grazzland/E-GIF-M-Board/README.md

# E-GIF-M-Board
Extendable Gateway and Industrial Firewall-ModBus
