grazzland/E-GIF-M-Board/E-GIF-M-Board.kicad_pcb

## KiCad design E-GIF-M-Board.kicad_pcb (2017-03-09)

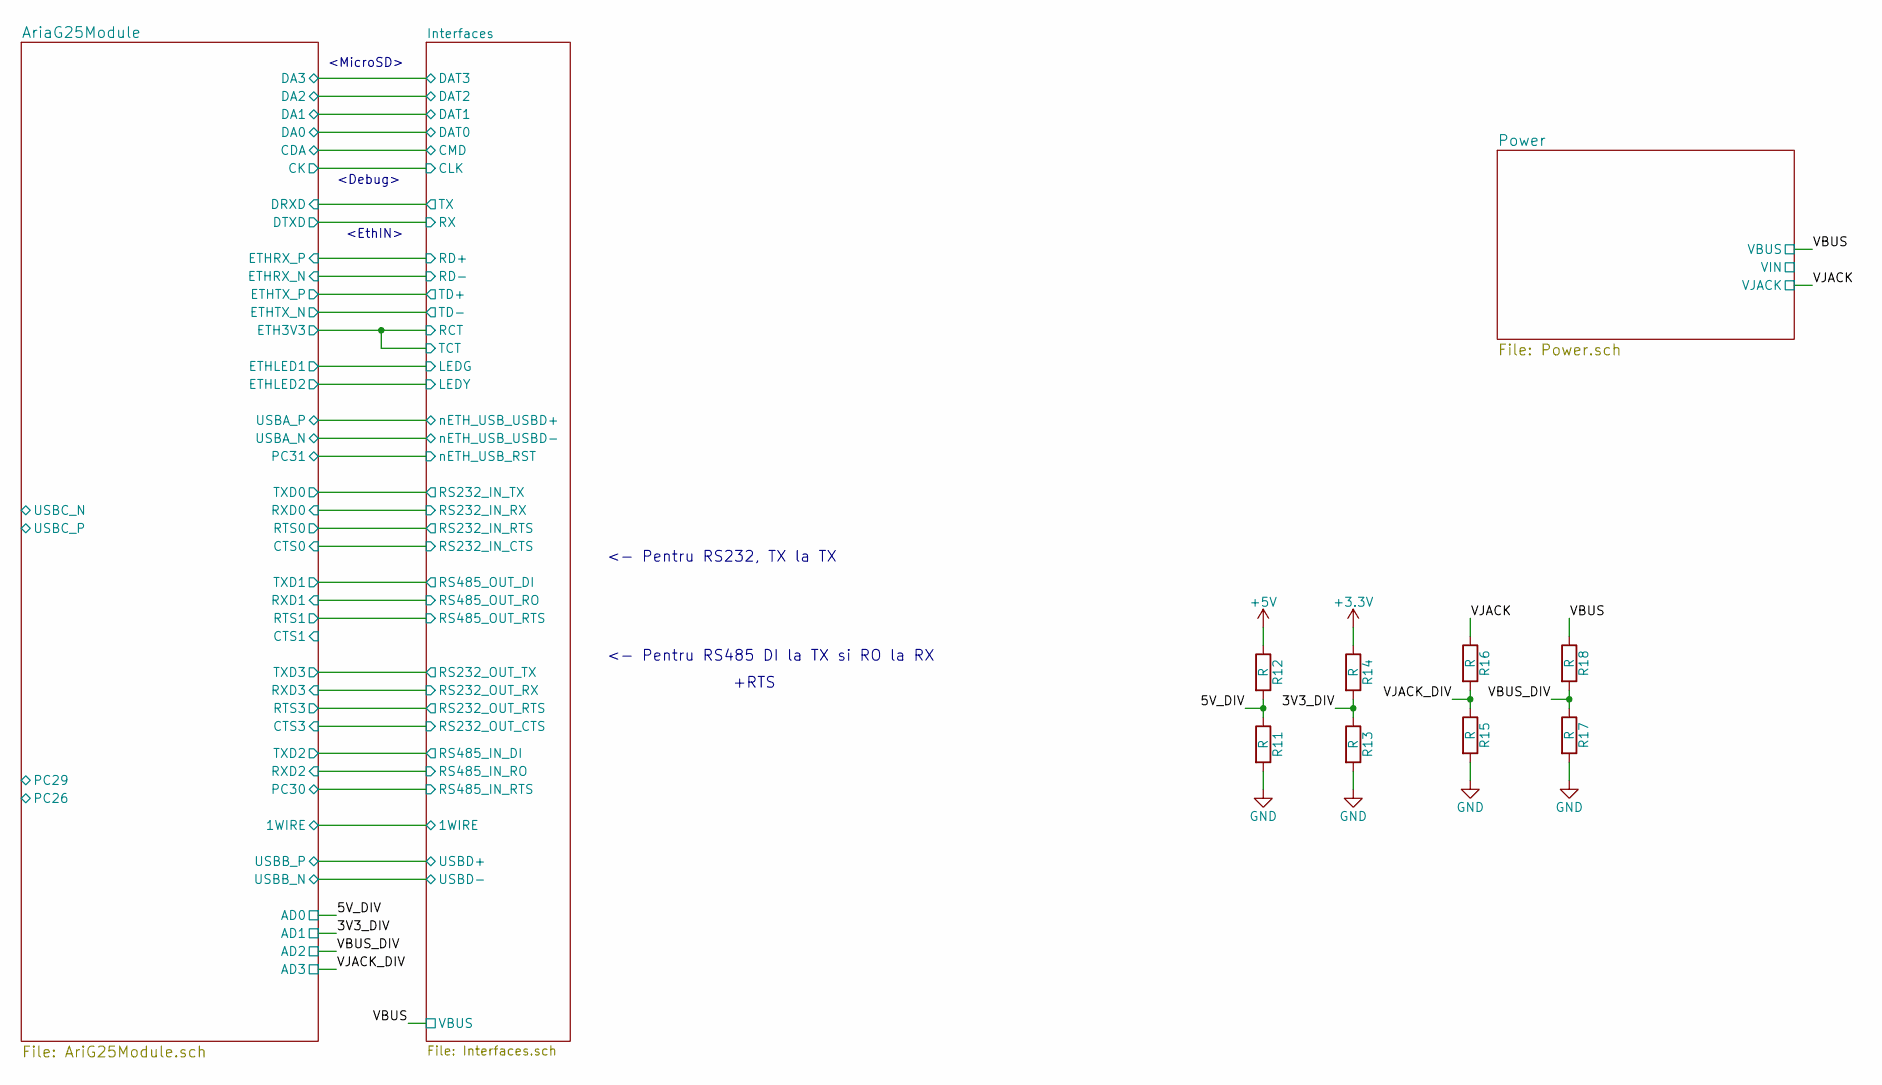
[picture p1: schematic E-GIF-M-Board.sch, E-GIF-M Board]

Parts:
R11, R12, R13, R14, R15, R16, R17, R18: R

Connections:
+3V3: R14.1; also elsewhere on the board
+5V: R12.1; also elsewhere on the board
/3V3_DIV: R13.1, R14.2; also elsewhere on the board
/5V_DIV: R11.1, R12.2; also elsewhere on the board
/VBUS: R18.1; also elsewhere on the board
/VBUS_DIV: R17.1, R18.2; also elsewhere on the board
/VJACK: R16.1; also elsewhere on the board
/VJACK_DIV: R15.1, R16.2; also elsewhere on the board
GND: R11.2, R13.2, R15.2, R17.2; also elsewhere on the board

Notes on the sheet:
<MicroSD>
<Debug>
<EthIN>
<- Pentru RS232, TX la TX
<- Pentru RS485 DI la TX si RO la RX
+RTS

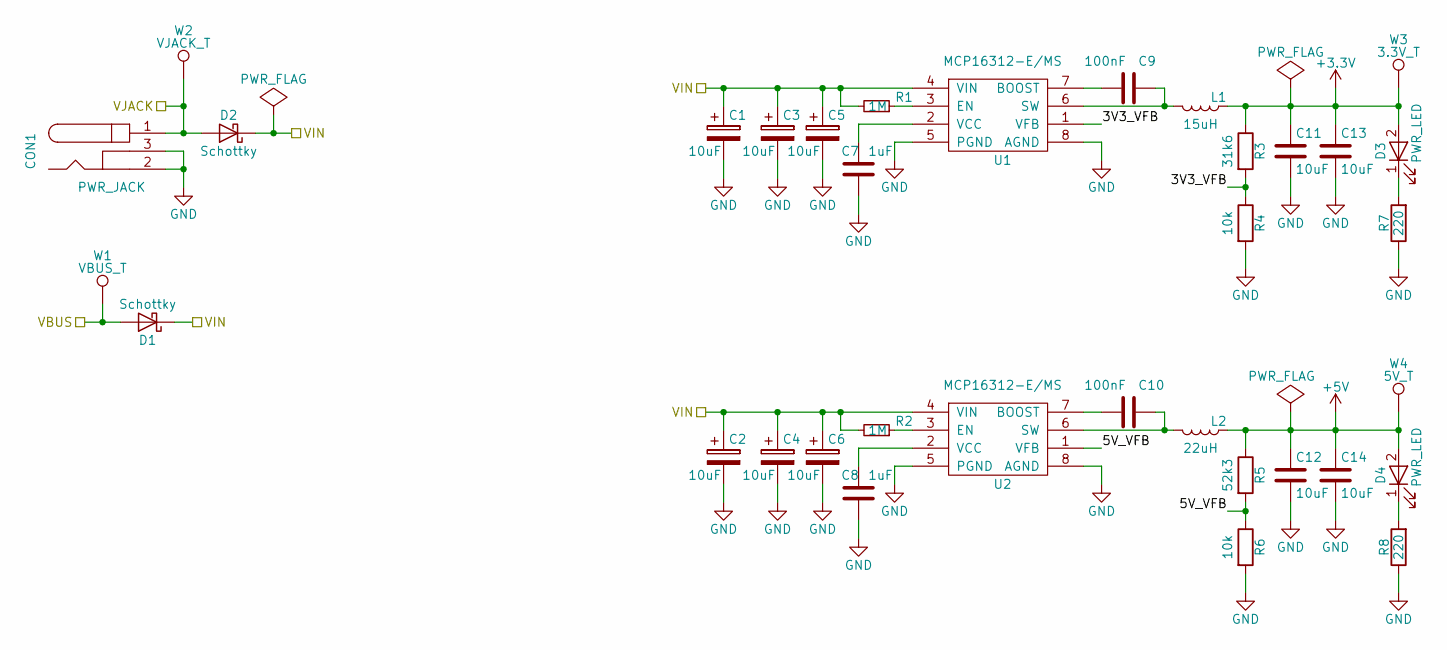
[picture p2: schematic Power.sch]

Parts:
C1, C2, C3, C4, C5, C6: 10uF; CP_Tantalum_Case-B_EIA-3528-21_Hand
C7, C8: 1uF; C_0603_HandSoldering
C9, C10: 100nF; C_0603_HandSoldering
C11, C12, C13, C14: 10uF; C_0603_HandSoldering
CON1: PWR_JACK; BARREL_JACK
D1, D2: Schottky; D_SMA-SMB_Universal_Handsoldering
D3, D4: PWR_LED; LED_0603
L1: 15uH; Inductor_Taiyo-Yuden_MD-5050
L2: 22uH; Inductor_Taiyo-Yuden_MD-5050
R1, R2: 1M; R_0603_HandSoldering
R3: 31k6; R_0603_HandSoldering
R4, R6: 10k; R_0603_HandSoldering
R5: 52k3; R_0603_HandSoldering
R7, R8: 220; R_0603_HandSoldering
U1, U2: MCP16312-E/MS; MSOP-8_3x3mm_Pitch0.65mm
W1: VBUS_T; Measurement_Point_Round-SMD-Pad_Small
W2: VJACK_T; Measurement_Point_Round-SMD-Pad_Small
W3: 3.3V_T; Measurement_Point_Round-SMD-Pad_Small
W4: 5V_T; Measurement_Point_Round-SMD-Pad_Small

Connections:
+3V3: C11.1, C13.1, D3.2 (A), L1.1, R3.1, W3.1; also elsewhere on the board
+5V: C12.1, C14.1, D4.2 (A), L2.1, R5.1, W4.1; also elsewhere on the board
/Power/3V3_VFB: R3.2, R4.1, U1.1 (VFB)
/Power/5V_VFB: R5.2, R6.1, U2.1 (VFB)
/Power/VIN: C1.1, C2.1, C3.1, C4.1, C5.1, C6.1, D1.1 (K), D2.1 (K), R1.2, R2.2, U1.4 (VIN), U2.4 (VIN)
/VBUS: D1.2 (A), W1.1; also elsewhere on the board
/VJACK: CON1.1, D2.2 (A), W2.1; also elsewhere on the board
GND: C1.2, C2.2, C3.2, C4.2, C5.2, C6.2, C7.2, C8.2, C11.2, C12.2, C13.2, C14.2, CON1.2, CON1.3, R4.2, R6.2, R7.1, R8.1, U1.5 (PGND), U1.8 (AGND), U2.5 (PGND), U2.8 (AGND); also elsewhere on the board
unnamed: C7.1, U1.2 (VCC)
unnamed: C8.1, U2.2 (VCC)
unnamed: C9.1, L1.2, U1.6 (SW)
unnamed: C9.2, U1.7 (BOOST)
unnamed: C10.1, L2.2, U2.6 (SW)
unnamed: C10.2, U2.7 (BOOST)
unnamed: D3.1 (K), R7.2
unnamed: D4.1 (K), R8.2
unnamed: R1.1, U1.3 (EN)
unnamed: R2.1, U2.3 (EN)

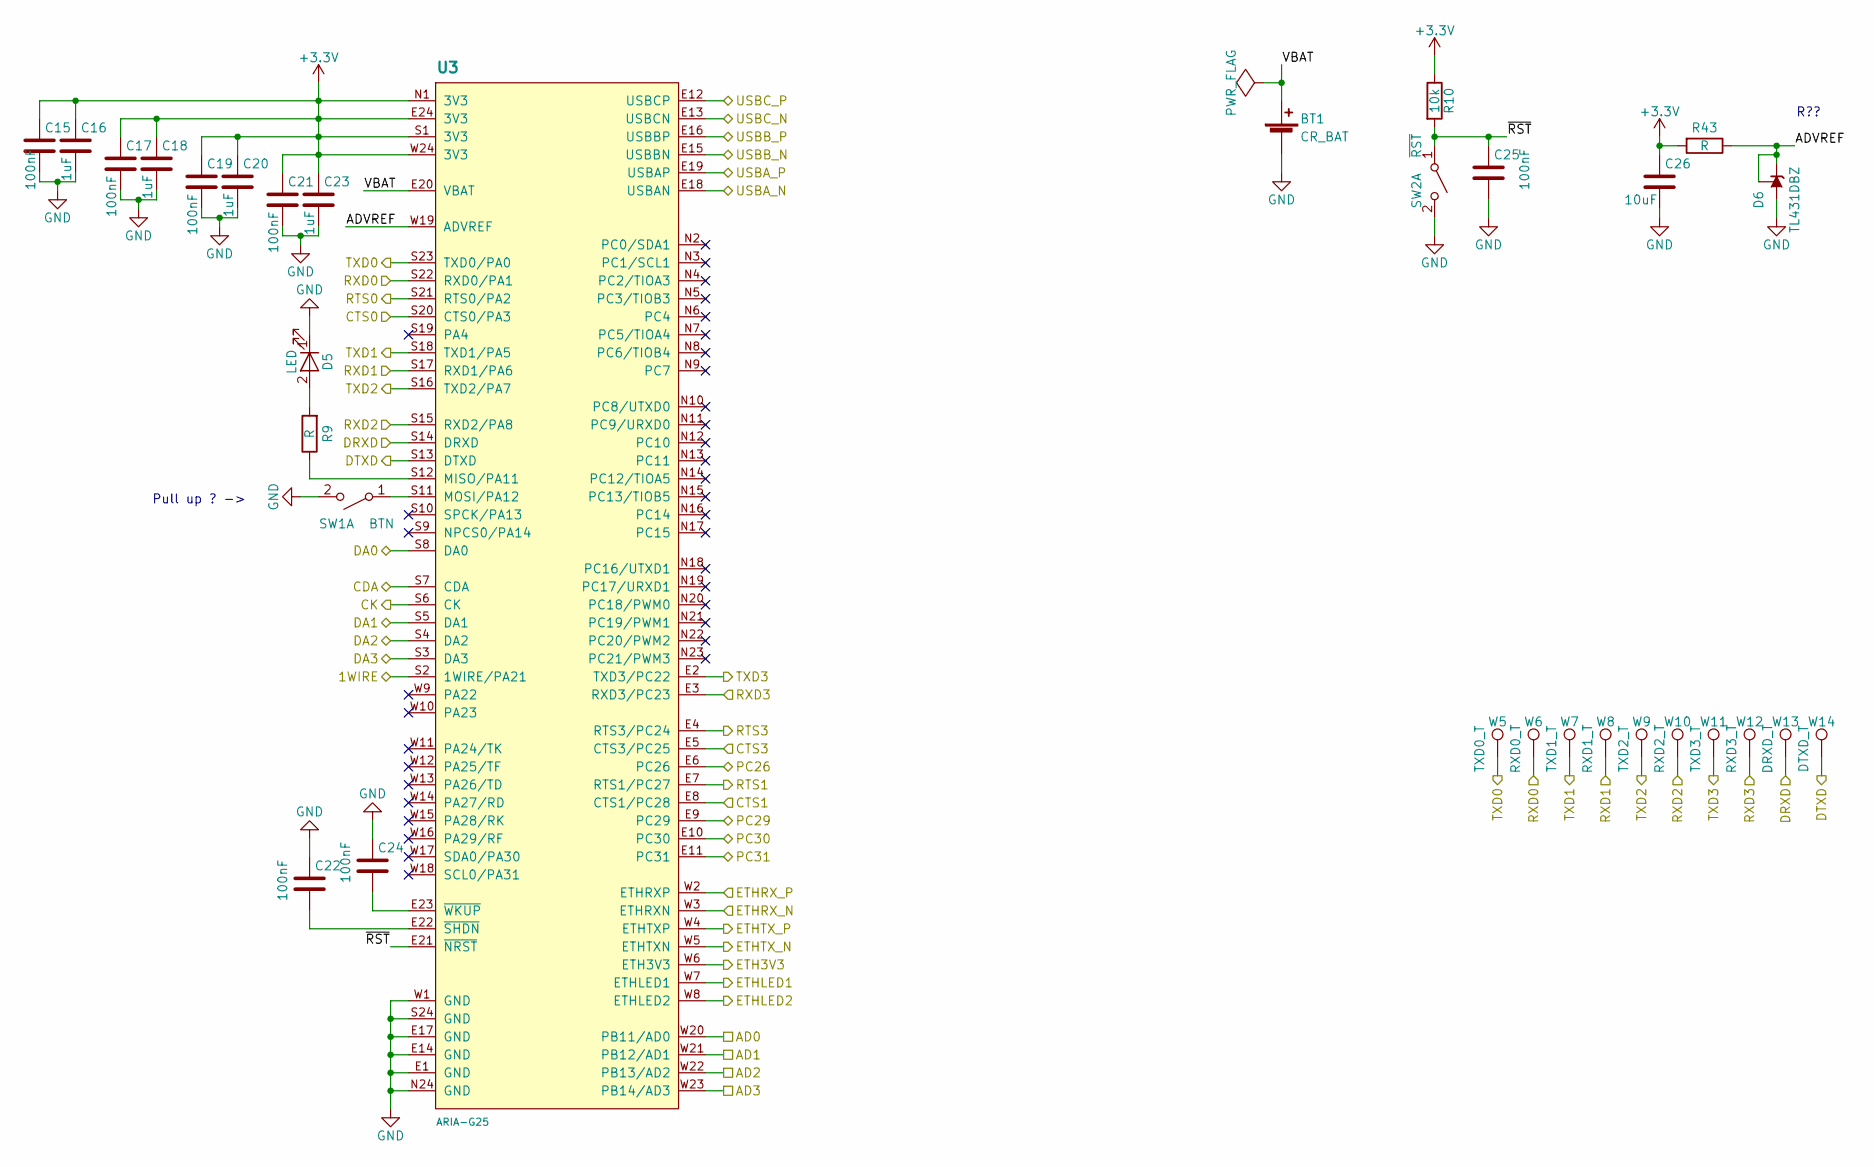
[picture p3: schematic AriG25Module.sch]

Parts:
BT1: CR_BAT; BatteryHolder_CoinCell_Keystone_3001
C15, C17, C19, C21, C22, C24, C25: 100nF; C_0603_HandSoldering
C16, C18, C20, C23: 1uF; C_0603_HandSoldering
C26: 10uF; C_0603_HandSoldering
D5: LED; LED_0603
D6: TL431DBZ; SOT-23
R9, R43: R; R_0603_HandSoldering
R10: 10k; R_0603_HandSoldering
SW1: BTN; SW_SPST_EVQPE1
SW2: ~RST; SW_SPST_EVQPE1
U3: ARIA-G25
W5: TXD0_T; Measurement_Point_Round-SMD-Pad_Small
W6: RXD0_T; Measurement_Point_Round-SMD-Pad_Small
W7: TXD1_T; Measurement_Point_Round-SMD-Pad_Small
W8: RXD1_T; Measurement_Point_Round-SMD-Pad_Small
W9: TXD2_T; Measurement_Point_Round-SMD-Pad_Small
W10: RXD2_T; Measurement_Point_Round-SMD-Pad_Small
W11: TXD3_T; Measurement_Point_Round-SMD-Pad_Small
W12: RXD3_T; Measurement_Point_Round-SMD-Pad_Small
W13: DRXD_T; Measurement_Point_Round-SMD-Pad_Small
W14: DTXD_T; Measurement_Point_Round-SMD-Pad_Small

Connections:
+3V3: C15.1, C16.1, C17.1, C18.1, C19.1, C20.1, C21.1, C23.1, C26.1, R10.1, R43.2, U3.E24 (3V3), U3.N1 (3V3), U3.S1 (3V3), U3.W24 (3V3); also elsewhere on the board
/3V3_DIV: U3.W21 (PB12/AD1); also elsewhere on the board
/5V_DIV: U3.W20 (PB11/AD0); also elsewhere on the board
/AriaG25Module/1WIRE: U3.S2 (1WIRE/PA21); also elsewhere on the board
/AriaG25Module/ADVREF: D6.1 (K), D6.2 (REF), R43.1, U3.W19 (ADVREF)
/AriaG25Module/CDA: U3.S7 (CDA); also elsewhere on the board
/AriaG25Module/CK: U3.S6 (CK); also elsewhere on the board
/AriaG25Module/CTS0: U3.S20 (CTS0/PA3); also elsewhere on the board
/AriaG25Module/CTS1: U3.E8 (CTS1/PC28)
/AriaG25Module/CTS3: U3.E5 (CTS3/PC25); also elsewhere on the board
/AriaG25Module/DA0: U3.S8 (DA0); also elsewhere on the board
/AriaG25Module/DA1: U3.S5 (DA1); also elsewhere on the board
/AriaG25Module/DA2: U3.S4 (DA2); also elsewhere on the board
/AriaG25Module/DA3: U3.S3 (DA3); also elsewhere on the board
/AriaG25Module/DRXD: U3.S14 (DRXD), W13.1; also elsewhere on the board
/AriaG25Module/DTXD: U3.S13 (DTXD), W14.1; also elsewhere on the board
/AriaG25Module/ETH3V3: U3.W6 (ETH3V3); also elsewhere on the board
/AriaG25Module/ETHLED1: U3.W7 (ETHLED1); also elsewhere on the board
/AriaG25Module/ETHLED2: U3.W8 (ETHLED2); also elsewhere on the board
/AriaG25Module/ETHRX_N: U3.W3 (ETHRXN); also elsewhere on the board
/AriaG25Module/ETHRX_P: U3.W2 (ETHRXP); also elsewhere on the board
/AriaG25Module/ETHTX_N: U3.W5 (ETHTXN); also elsewhere on the board
/AriaG25Module/ETHTX_P: U3.W4 (ETHTXP); also elsewhere on the board
/AriaG25Module/PC26: U3.E6 (PC26)
/AriaG25Module/PC29: U3.E9 (PC29)
/AriaG25Module/PC30: U3.E10 (PC30); also elsewhere on the board
/AriaG25Module/PC31: U3.E11 (PC31); also elsewhere on the board
/AriaG25Module/USBA_N: U3.E18 (USBAN); also elsewhere on the board
/AriaG25Module/USBA_P: U3.E19 (USBAP); also elsewhere on the board
/AriaG25Module/USBB_N: U3.E15 (USBBN); also elsewhere on the board
/AriaG25Module/USBB_P: U3.E16 (USBBP); also elsewhere on the board
/AriaG25Module/USBC_N: U3.E13 (USBCN)
/AriaG25Module/USBC_P: U3.E12 (USBCP)
/AriaG25Module/VBAT: BT1.1 (+), U3.E20 (VBAT)
/AriaG25Module/~RST: C25.1, R10.2, SW2.1 (A), U3.E21 (~NRST)
/Interfaces/RS232_IN_RTS: U3.S21 (RTS0/PA2); also elsewhere on the board
/Interfaces/RS232_IN_RX: U3.S22 (RXD0/PA1), W6.1; also elsewhere on the board
/Interfaces/RS232_IN_TX: U3.S23 (TXD0/PA0), W5.1; also elsewhere on the board
/Interfaces/RS232_OUT_RTS: U3.E4 (RTS3/PC24); also elsewhere on the board
/Interfaces/RS232_OUT_RX: U3.E3 (RXD3/PC23), W12.1; also elsewhere on the board
/Interfaces/RS232_OUT_TX: U3.E2 (TXD3/PC22), W11.1; also elsewhere on the board
/Interfaces/RS485_IN_DI: U3.S16 (TXD2/PA7), W9.1; also elsewhere on the board
/Interfaces/RS485_IN_RO: U3.S15 (RXD2/PA8), W10.1; also elsewhere on the board
/Interfaces/RS485_OUT_DI: U3.S18 (TXD1/PA5), W7.1; also elsewhere on the board
/Interfaces/RS485_OUT_RO: U3.S17 (RXD1/PA6), W8.1; also elsewhere on the board
/Interfaces/RS485_OUT_RTS: U3.E7 (RTS1/PC27); also elsewhere on the board
/VBUS_DIV: U3.W22 (PB13/AD2); also elsewhere on the board
/VJACK_DIV: U3.W23 (PB14/AD3); also elsewhere on the board
GND: BT1.2 (-), C15.2, C16.2, C17.2, C18.2, C19.2, C20.2, C21.2, C22.1, C23.2, C24.1, C25.2, C26.2, D5.1 (K), D6.3 (A), SW1.2 (B), SW2.2 (B), U3.E1 (GND), U3.E14 (GND), U3.E17 (GND), U3.GND, U3.N24 (GND), U3.S24 (GND), U3.W1 (GND); also elsewhere on the board
unnamed: C22.2, U3.E22 (~SHDN)
unnamed: C24.2, U3.E23 (~WKUP)
unnamed: D5.2 (A), R9.2
unnamed: R9.1, U3.S12 (MISO/PA11)
unnamed: SW1.1 (A), U3.S11 (MOSI/PA12)

Notes on the sheet:
R??
Pull up ? ->

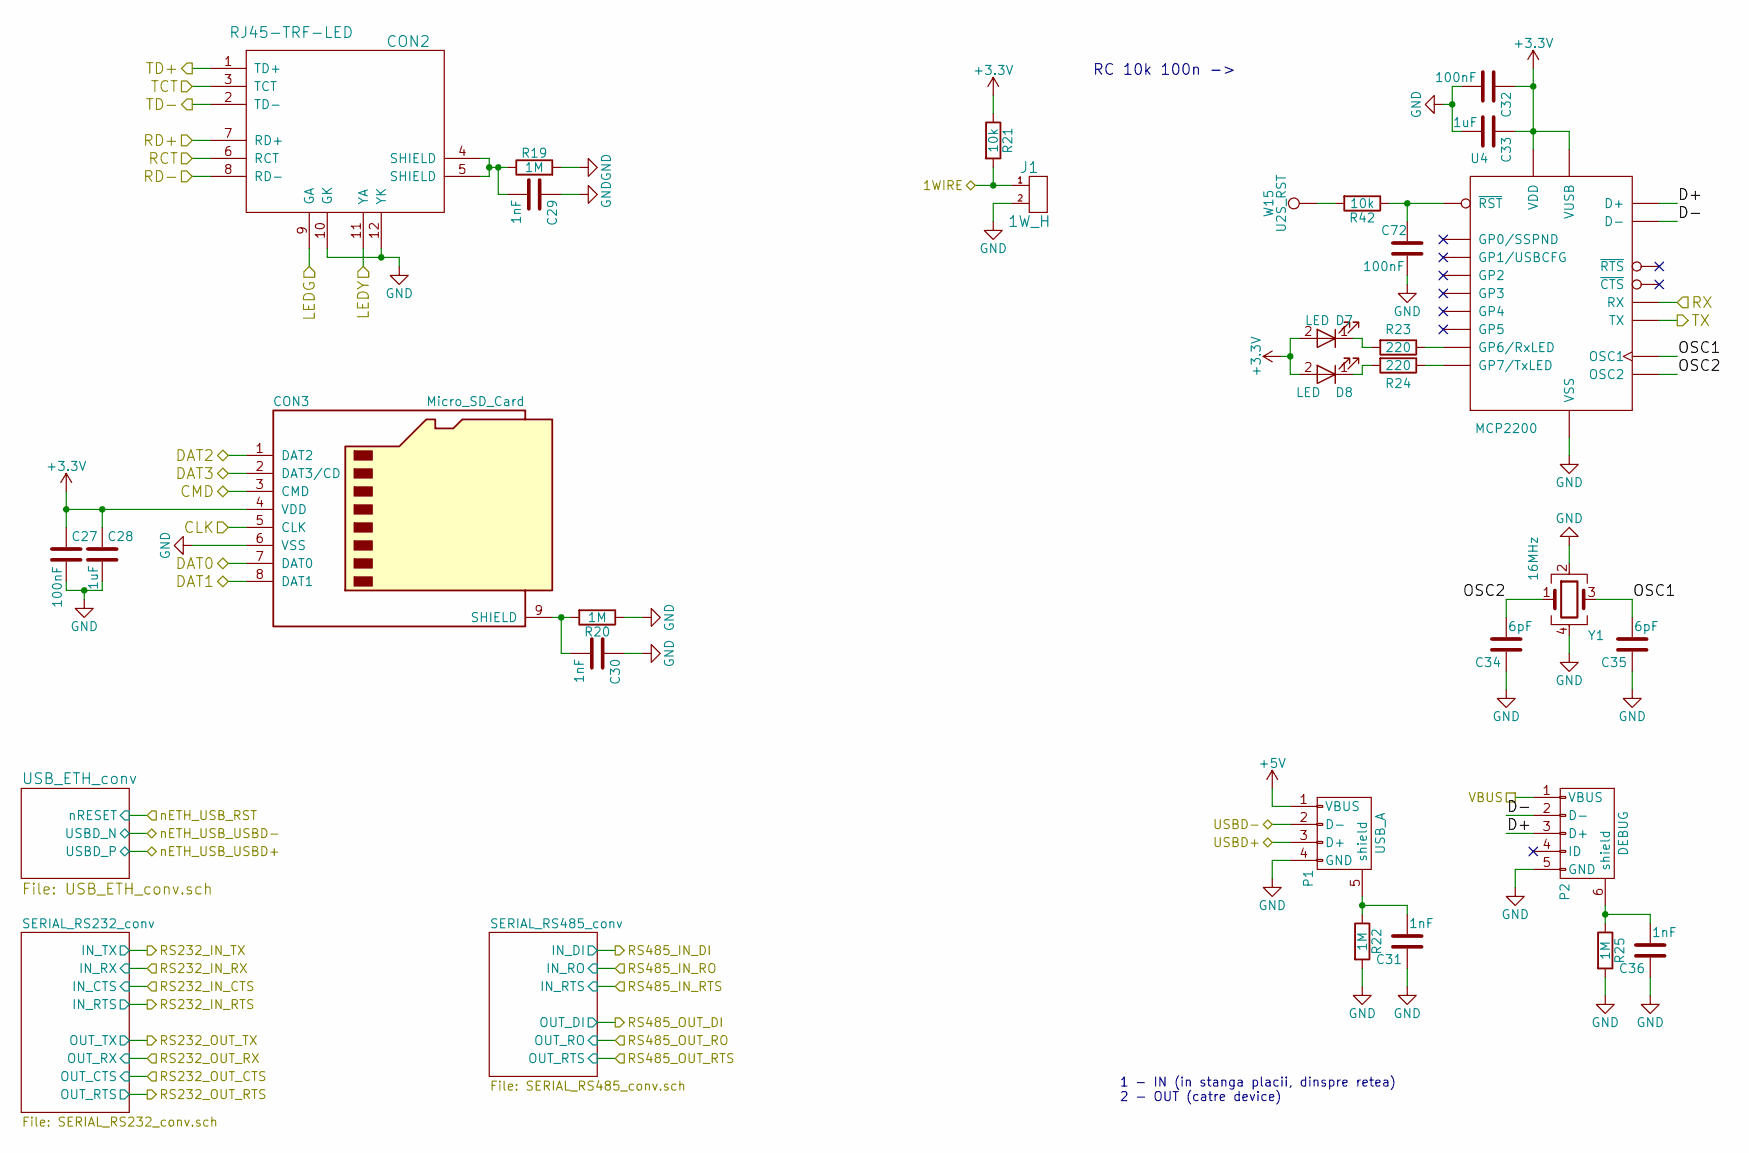
[picture p4: schematic Interfaces.sch]

Parts:
C27, C32, C72: 100nF; C_0603_HandSoldering
C28, C33: 1uF; C_0603_HandSoldering
C29, C30, C31, C36: 1nF; C_0603_HandSoldering
C34, C35: 6pF; C_0603_HandSoldering
CON2: RJ45-TRF-LED; RJ45_TRANSFO
CON3: Micro_SD_Card; MicroSDSocket
D7, D8: LED; LED_0603
J1: 1W_H; Pin_Header_Straight_1x02_Pitch1.27mm
P1: USB_A
P2: DEBUG; MicroUSB-B
R19, R20, R22, R25: 1M; R_0603_HandSoldering
R21, R42: 10k; R_0603_HandSoldering
R23, R24: 220; R_0603_HandSoldering
U4: MCP2200; SSOP-20_4.4x6.5mm_Pitch0.65mm
W15: U2S_RST; Measurement_Point_Round-SMD-Pad_Small
Y1: 16MHz; Crystal_SMD_3225-4pin_3.2x2.5mm_HandSoldering

Connections:
+3V3: C27.1, C28.1, C32.1, C33.1, CON3.4 (VDD), D7.2 (A), D8.2 (A), R21.1, U4.1 (VDD), U4.17 (VUSB); also elsewhere on the board
+5V: P1.1 (VBUS); also elsewhere on the board
/AriaG25Module/1WIRE: J1.1, R21.2; also elsewhere on the board
/AriaG25Module/CDA: CON3.3 (CMD); also elsewhere on the board
/AriaG25Module/CK: CON3.5 (CLK); also elsewhere on the board
/AriaG25Module/DA0: CON3.7 (DAT0); also elsewhere on the board
/AriaG25Module/DA1: CON3.8 (DAT1); also elsewhere on the board
/AriaG25Module/DA2: CON3.1 (DAT2); also elsewhere on the board
/AriaG25Module/DA3: CON3.2 (DAT3/CD); also elsewhere on the board
/AriaG25Module/DRXD: U4.10 (TX); also elsewhere on the board
/AriaG25Module/DTXD: U4.12 (RX); also elsewhere on the board
/AriaG25Module/ETH3V3: CON2.3 (TCT), CON2.6 (RCT); also elsewhere on the board
/AriaG25Module/ETHLED1: CON2.9 (GA); also elsewhere on the board
/AriaG25Module/ETHLED2: CON2.11 (YA); also elsewhere on the board
/AriaG25Module/ETHRX_N: CON2.8 (RD-); also elsewhere on the board
/AriaG25Module/ETHRX_P: CON2.7 (RD+); also elsewhere on the board
/AriaG25Module/ETHTX_N: CON2.2 (TD-); also elsewhere on the board
/AriaG25Module/ETHTX_P: CON2.1 (TD+); also elsewhere on the board
/AriaG25Module/USBB_N: P1.2 (D-); also elsewhere on the board
/AriaG25Module/USBB_P: P1.3 (D+); also elsewhere on the board
/Interfaces/D+: P2.3 (D+), U4.19 (D+)
/Interfaces/D-: P2.2 (D-), U4.18 (D-)
/Interfaces/OSC1: C35.2, U4.2 (OSC1), Y1.3
/Interfaces/OSC2: C34.2, U4.3 (OSC2), Y1.1
/VBUS: P2.1 (VBUS); also elsewhere on the board
GND: C27.2, C28.2, C29.1, C30.1, C31.1, C32.2, C33.2, C34.1, C35.1, C36.1, C72.2, CON2.10 (GK), CON2.12 (YK), CON3.6 (VSS), J1.2, P1.4 (GND), P2.5 (GND), R19.2, R20.1, R22.2, R25.2, U4.20 (VSS), Y1.2, Y1.4; also elsewhere on the board
unnamed: C29.2, CON2.4 (SHIELD), CON2.5 (SHIELD), R19.1
unnamed: C30.2, CON3.9 (SHIELD), R20.2
unnamed: C31.2, P1.5 (shield), R22.1
unnamed: C36.2, P2.6 (shield), R25.1
unnamed: C72.1, R42.1, U4.4 (~RST)
unnamed: D7.1 (K), R23.2
unnamed: D8.1 (K), R24.2
unnamed: R23.1, U4.6 (GP6/RxLED)
unnamed: R24.1, U4.5 (GP7/TxLED)
unnamed: R42.2, W15.1

Notes on the sheet:
1 - IN (in stanga placii, dinspre retea) 2 - OUT (catre device)
RC 10k 100n ->

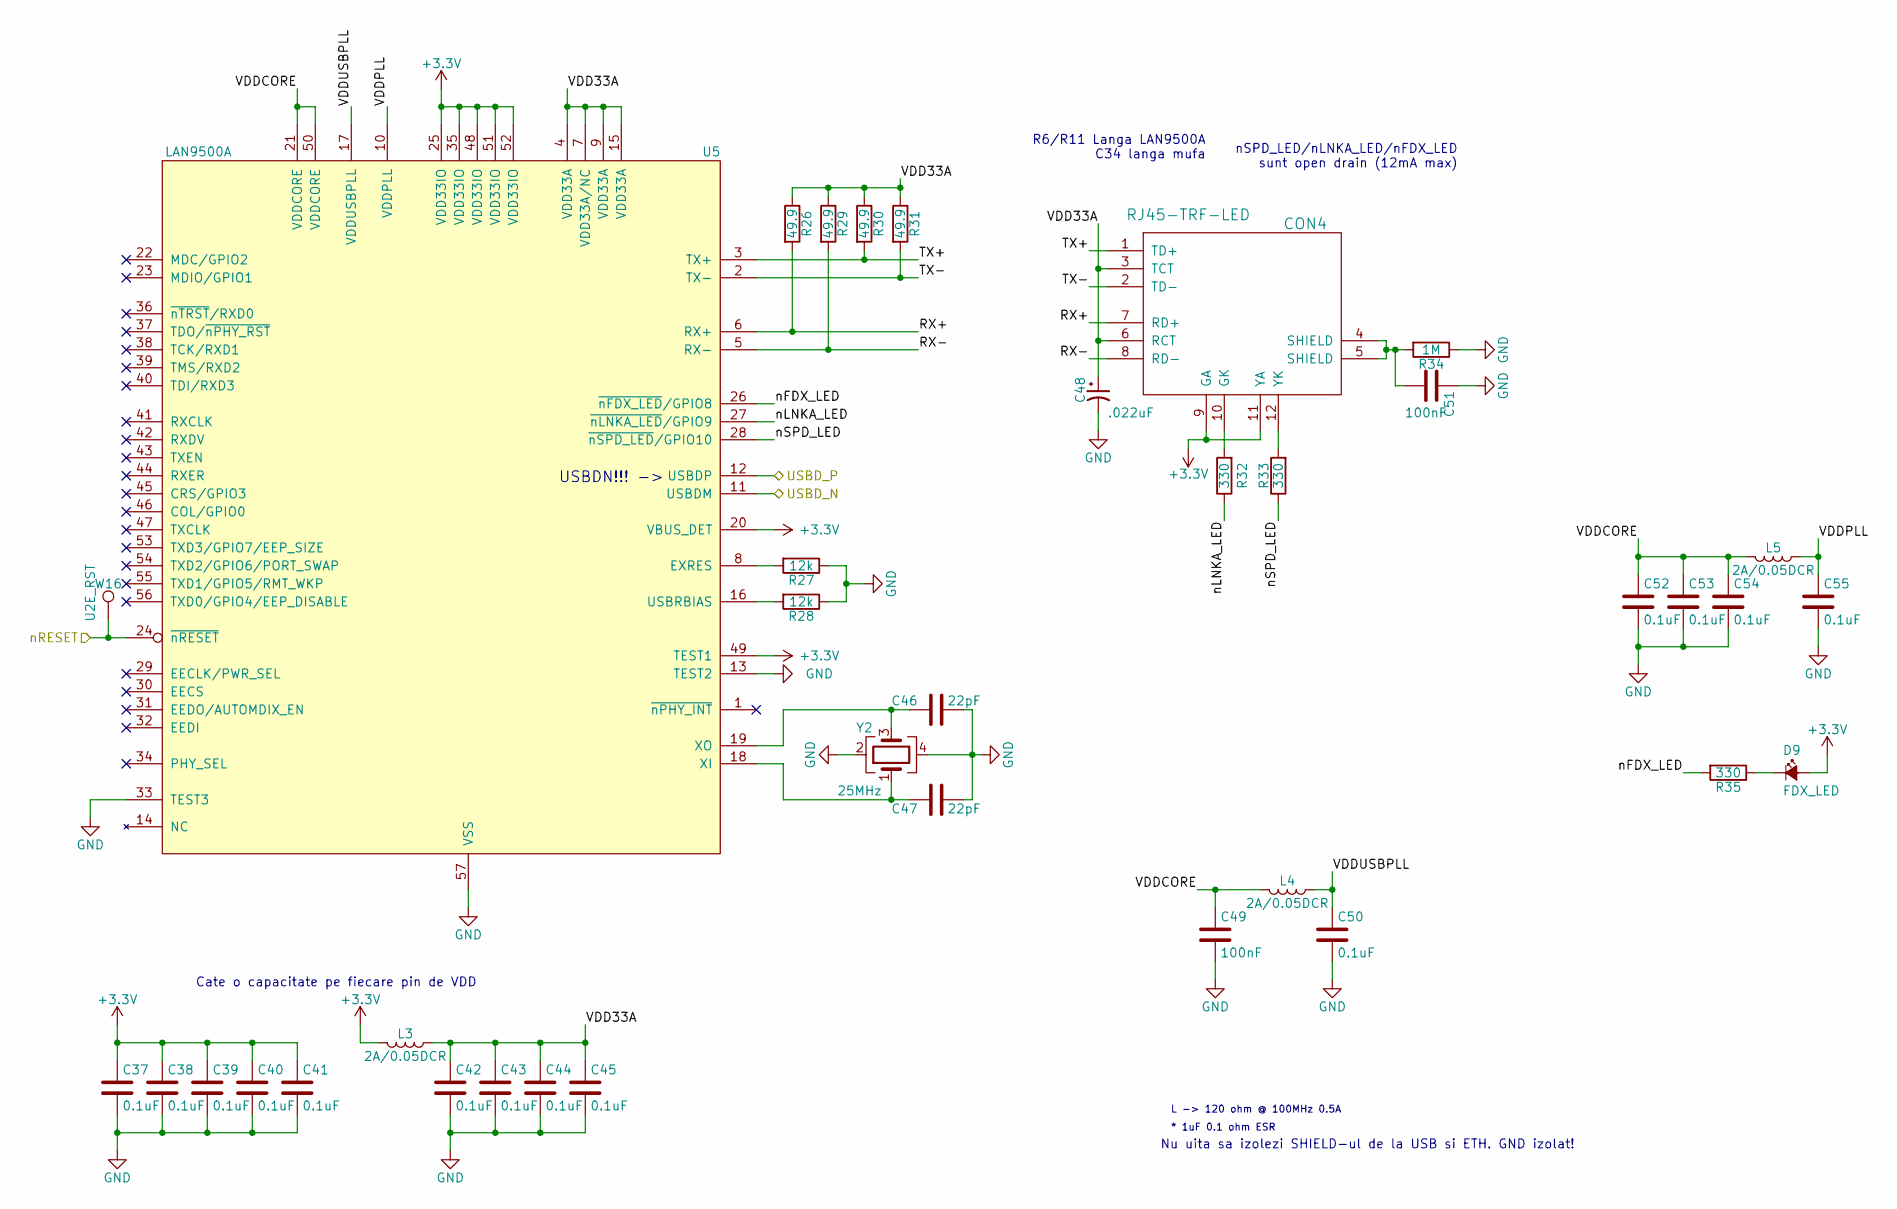
[picture p5: schematic USB_ETH_conv.sch]

Parts:
C37, C38, C39, C40, C41, C42, C43, C44, C45, C50, C52, C53, C54, C55: 0.1uF; C_0603_HandSoldering
C46, C47: 22pF; C_0603_HandSoldering
C48: .022uF; CP_Tantalum_Case-C_EIA-6032-28_Hand
C49, C51: 100nF; C_0603_HandSoldering
CON4: RJ45-TRF-LED; RJ45_TRANSFO
D9: FDX_LED; LED_0603
L3, L4, L5: 2A/0.05DCR; R_0603_HandSoldering
R26, R29, R30, R31: 49.9; R_0603_HandSoldering
R27, R28: 12k; R_0603_HandSoldering
R32, R33, R35: 330; R_0603_HandSoldering
R34: 1M; R_0603_HandSoldering
U5: LAN9500A; QFN-56-1EP_7x7mm_Pitch0.4mm
W16: U2E_RST; Measurement_Point_Round-SMD-Pad_Small
Y2: 25MHz; Crystal_SMD_3225-4pin_3.2x2.5mm_HandSoldering

Connections:
+3V3: C37.1, C38.1, C39.1, C40.1, C41.1, CON4.9 (GA), CON4.11 (YA), D9.2 (A), L3.2, U5.20 (VBUS_DET), U5.25 (VDD33IO), U5.35 (VDD33IO), U5.48 (VDD33IO), U5.49 (TEST1), U5.51 (VDD33IO), U5.52 (VDD33IO); also elsewhere on the board
/AriaG25Module/PC31: U5.24 (~nRESET), W16.1; also elsewhere on the board
/AriaG25Module/USBA_N: U5.11 (USBDM); also elsewhere on the board
/AriaG25Module/USBA_P: U5.12 (USBDP); also elsewhere on the board
/Interfaces/USB_ETH_conv/RX+: CON4.7 (RD+), R26.2, U5.6 (RX+)
/Interfaces/USB_ETH_conv/RX-: CON4.8 (RD-), R29.2, U5.5 (RX-)
/Interfaces/USB_ETH_conv/TX+: CON4.1 (TD+), R30.2, U5.3 (TX+)
/Interfaces/USB_ETH_conv/TX-: CON4.2 (TD-), R31.2, U5.2 (TX-)
/Interfaces/USB_ETH_conv/VDD33A: C42.1, C43.1, C44.1, C45.1, C48.1, CON4.3 (TCT), CON4.6 (RCT), L3.1, R26.1, R29.1, R30.1, R31.1, U5.4 (VDD33A), U5.7 (VDD33A/NC), U5.9 (VDD33A), U5.15 (VDD33A)
/Interfaces/USB_ETH_conv/VDDCORE: C49.1, C52.1, C53.1, C54.1, L4.2, L5.2, U5.21 (VDDCORE), U5.50 (VDDCORE)
/Interfaces/USB_ETH_conv/VDDPLL: C55.1, L5.1, U5.10 (VDDPLL)
/Interfaces/USB_ETH_conv/VDDUSBPLL: C50.1, L4.1, U5.17 (VDDUSBPLL)
/Interfaces/USB_ETH_conv/nFDX_LED: R35.2, U5.26 (~nFDX_LED~/GPIO8)
/Interfaces/USB_ETH_conv/nLNKA_LED: R32.1, U5.27 (~nLNKA_LED~/GPIO9)
/Interfaces/USB_ETH_conv/nSPD_LED: R33.1, U5.28 (~nSPD_LED~/GPIO10)
GND: C37.2, C38.2, C39.2, C40.2, C41.2, C42.2, C43.2, C44.2, C45.2, C46.2, C47.2, C48.2, C49.2, C50.2, C51.1, C52.2, C53.2, C54.2, C55.2, R27.1, R28.1, R34.1, U5.13 (TEST2), U5.33 (TEST3), U5.57 (VSS), Y2.2, Y2.4; also elsewhere on the board
unnamed: C46.1, U5.19 (XO), Y2.3
unnamed: C47.1, U5.18 (XI), Y2.1
unnamed: C51.2, CON4.4 (SHIELD), CON4.5 (SHIELD), R34.2
unnamed: CON4.10 (GK), R32.2
unnamed: CON4.12 (YK), R33.2
unnamed: D9.1 (K), R35.1
unnamed: R27.2, U5.8 (EXRES)
unnamed: R28.2, U5.16 (USBRBIAS)

Notes on the sheet:
L -> 120 ohm @ 100MHz 0.5A
* 1uF 0.1 ohm ESR
Nu uita sa izolezi SHIELD-ul de la USB si ETH. GND izolat!
nSPD_LED/nLNKA_LED/nFDX_LED sunt open drain (12mA max)
R6/R11 Langa LAN9500A C34 langa mufa
Cate o capacitate pe fiecare pin de VDD
USBDN!!! ->

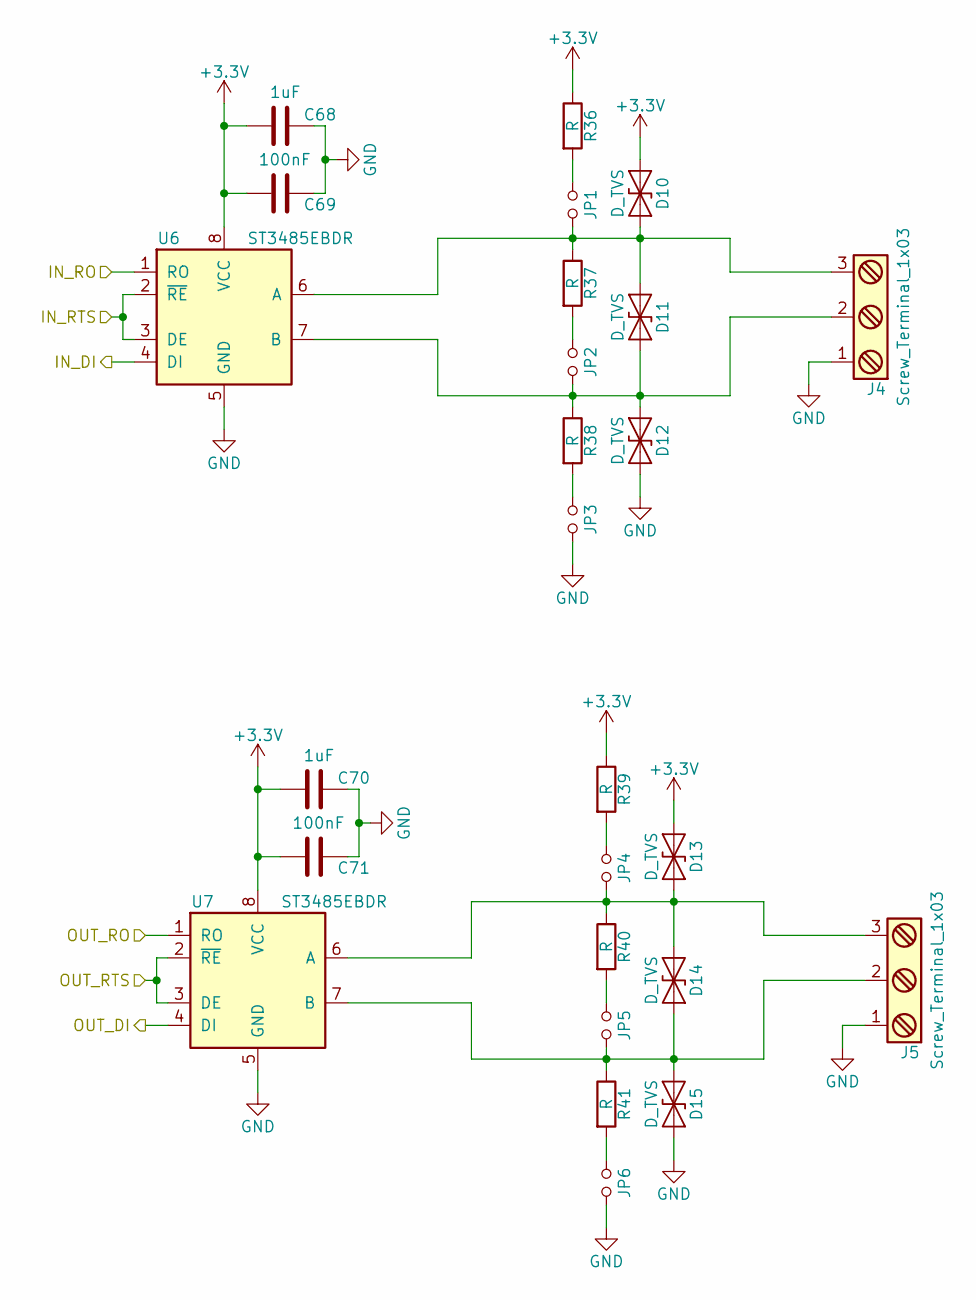
[picture p6: schematic SERIAL_RS485_conv.sch]

Parts:
C68, C70: 1uF; C_0603_HandSoldering
C69, C71: 100nF; C_0603_HandSoldering
D10, D11, D12, D13, D14, D15: D_TVS; D_SMA-SMB_Universal_Handsoldering
J4, J5: Screw_Terminal_1x03; TerminalBlock_Pheonix_PT-3.5mm_3pol
JP1, JP2, JP3, JP4, JP5, JP6: Jumper_NO_Small; Pin_Header_Straight_1x02_Pitch2.54mm
R36, R37, R38, R39, R40, R41: R; R_0603_HandSoldering
U6, U7: ST3485EBDR; SO-8

Connections:
+3V3: C68.2, C69.2, C70.2, C71.2, D10.1 (A1), D13.1 (A1), R36.1, R39.1, U6.8 (VCC), U7.8 (VCC); also elsewhere on the board
/AriaG25Module/PC30: U6.2 (~RE~), U6.3 (DE); also elsewhere on the board
/Interfaces/RS485_IN_DI: U6.4 (DI); also elsewhere on the board
/Interfaces/RS485_IN_RO: U6.1 (RO); also elsewhere on the board
/Interfaces/RS485_OUT_DI: U7.4 (DI); also elsewhere on the board
/Interfaces/RS485_OUT_RO: U7.1 (RO); also elsewhere on the board
/Interfaces/RS485_OUT_RTS: U7.2 (~RE~), U7.3 (DE); also elsewhere on the board
GND: C68.1, C69.1, C70.1, C71.1, D12.2 (A2), D15.2 (A2), J4.1, J5.1, JP3.2, JP6.2, U6.5 (GND), U7.5 (GND); also elsewhere on the board
unnamed: D10.2 (A2), D11.1 (A1), J4.3, JP1.2, R37.1, U6.6 (A)
unnamed: D11.2 (A2), D12.1 (A1), J4.2, JP2.2, R38.1, U6.7 (B)
unnamed: D13.2 (A2), D14.1 (A1), J5.3, JP4.2, R40.1, U7.6 (A)
unnamed: D14.2 (A2), D15.1 (A1), J5.2, JP5.2, R41.1, U7.7 (B)
unnamed: JP1.1, R36.2
unnamed: JP2.1, R37.2
unnamed: JP3.1, R38.2
unnamed: JP4.1, R39.2
unnamed: JP5.1, R40.2
unnamed: JP6.1, R41.2

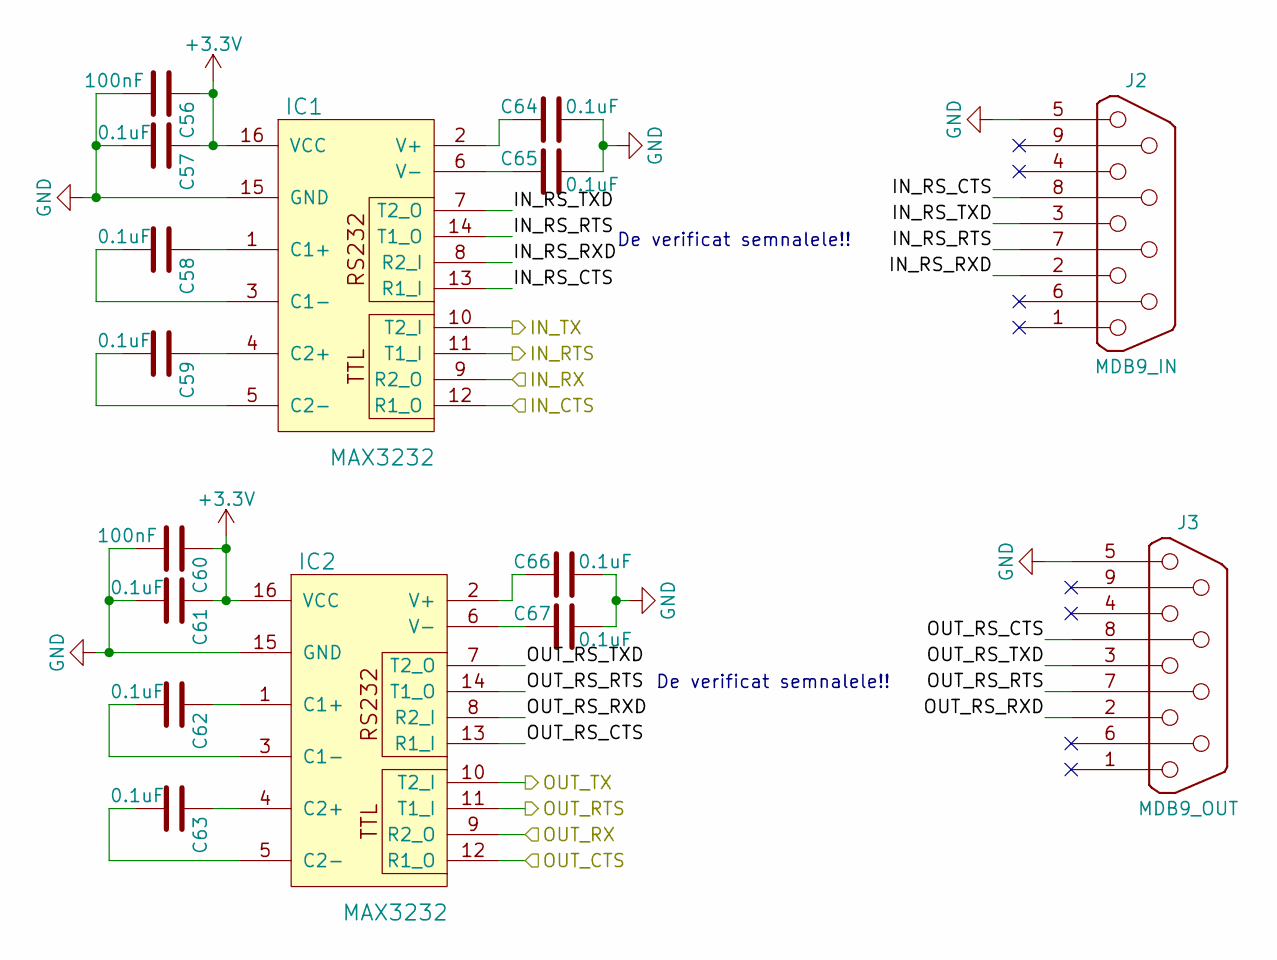
[picture p7: schematic SERIAL_RS232_conv.sch]

Parts:
C56, C60: 100nF; C_0603_HandSoldering
C57, C58, C59, C61, C62, C63, C64, C65, C66, C67: 0.1uF; C_0603_HandSoldering
IC1, IC2: MAX3232; SSOP-16_3.9x4.9mm_Pitch0.635mm
J2: MDB9_IN; DB9FC
J3: MDB9_OUT; DB9FC

Connections:
+3V3: C56.1, C57.1, C60.1, C61.1, IC1.16 (VCC), IC2.16 (VCC); also elsewhere on the board
/AriaG25Module/CTS0: IC1.12 (R1_O); also elsewhere on the board
/AriaG25Module/CTS3: IC2.12 (R1_O); also elsewhere on the board
/Interfaces/RS232_IN_RTS: IC1.11 (T1_I); also elsewhere on the board
/Interfaces/RS232_IN_RX: IC1.9 (R2_O); also elsewhere on the board
/Interfaces/RS232_IN_TX: IC1.10 (T2_I); also elsewhere on the board
/Interfaces/RS232_OUT_RTS: IC2.11 (T1_I); also elsewhere on the board
/Interfaces/RS232_OUT_RX: IC2.9 (R2_O); also elsewhere on the board
/Interfaces/RS232_OUT_TX: IC2.10 (T2_I); also elsewhere on the board
/Interfaces/SERIAL_RS232_conv/IN_RS_CTS: IC1.13 (R1_I), J2.8
/Interfaces/SERIAL_RS232_conv/IN_RS_RTS: IC1.14 (T1_O), J2.7
/Interfaces/SERIAL_RS232_conv/IN_RS_RXD: IC1.8 (R2_I), J2.2
/Interfaces/SERIAL_RS232_conv/IN_RS_TXD: IC1.7 (T2_O), J2.3
/Interfaces/SERIAL_RS232_conv/OUT_RS_CTS: IC2.13 (R1_I), J3.8
/Interfaces/SERIAL_RS232_conv/OUT_RS_RTS: IC2.14 (T1_O), J3.7
/Interfaces/SERIAL_RS232_conv/OUT_RS_RXD: IC2.8 (R2_I), J3.2
/Interfaces/SERIAL_RS232_conv/OUT_RS_TXD: IC2.7 (T2_O), J3.3
GND: C56.2, C57.2, C60.2, C61.2, C64.1, C65.1, C66.1, C67.1, IC1.15 (GND), IC2.15 (GND), J2.5, J3.5; also elsewhere on the board
unnamed: C58.1, IC1.1 (C1+)
unnamed: C58.2, IC1.3 (C1-)
unnamed: C59.1, IC1.4 (C2+)
unnamed: C59.2, IC1.5 (C2-)
unnamed: C62.1, IC2.1 (C1+)
unnamed: C62.2, IC2.3 (C1-)
unnamed: C63.1, IC2.4 (C2+)
unnamed: C63.2, IC2.5 (C2-)
unnamed: C64.2, IC1.2 (V+)
unnamed: C65.2, IC1.6 (V-)
unnamed: C66.2, IC2.2 (V+)
unnamed: C67.2, IC2.6 (V-)

Notes on the sheet:
De verificat semnalele!!
