grazzland/E-GIF-M-Board/E-GIF-M-Board.kicad_pcb

## KiCad design E-GIF-M-Board.kicad_pcb (continued)

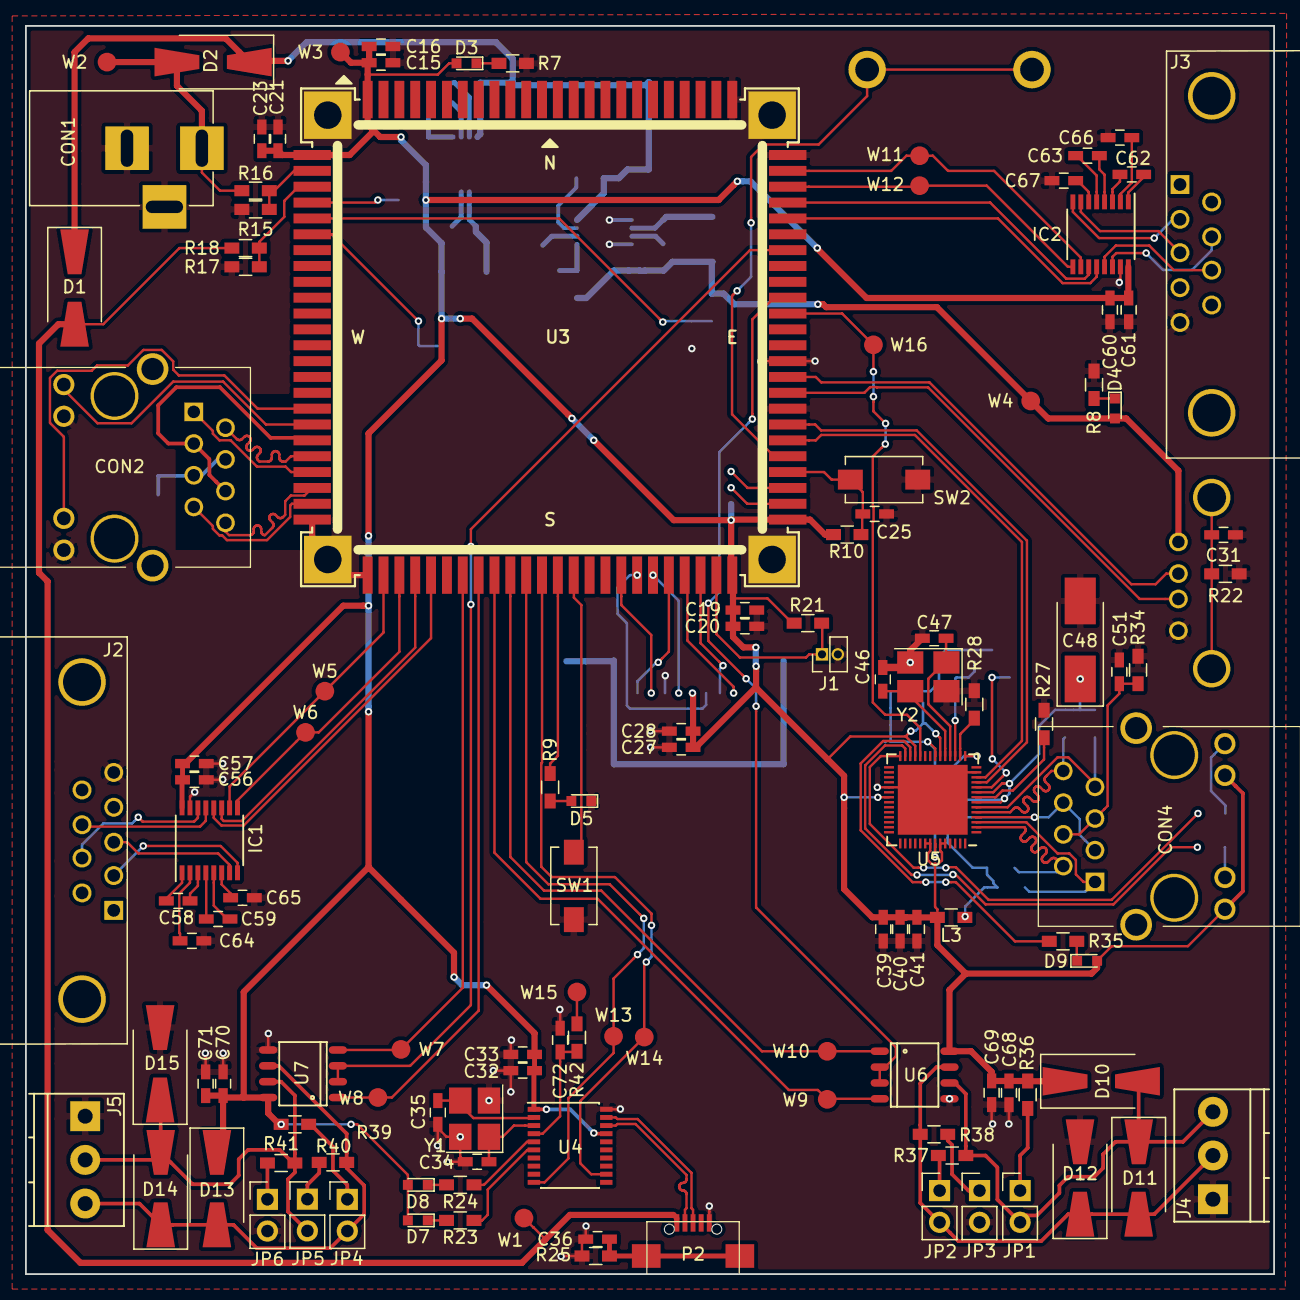
[picture p8: board E-GIF-M-Board.kicad_pcb from above]

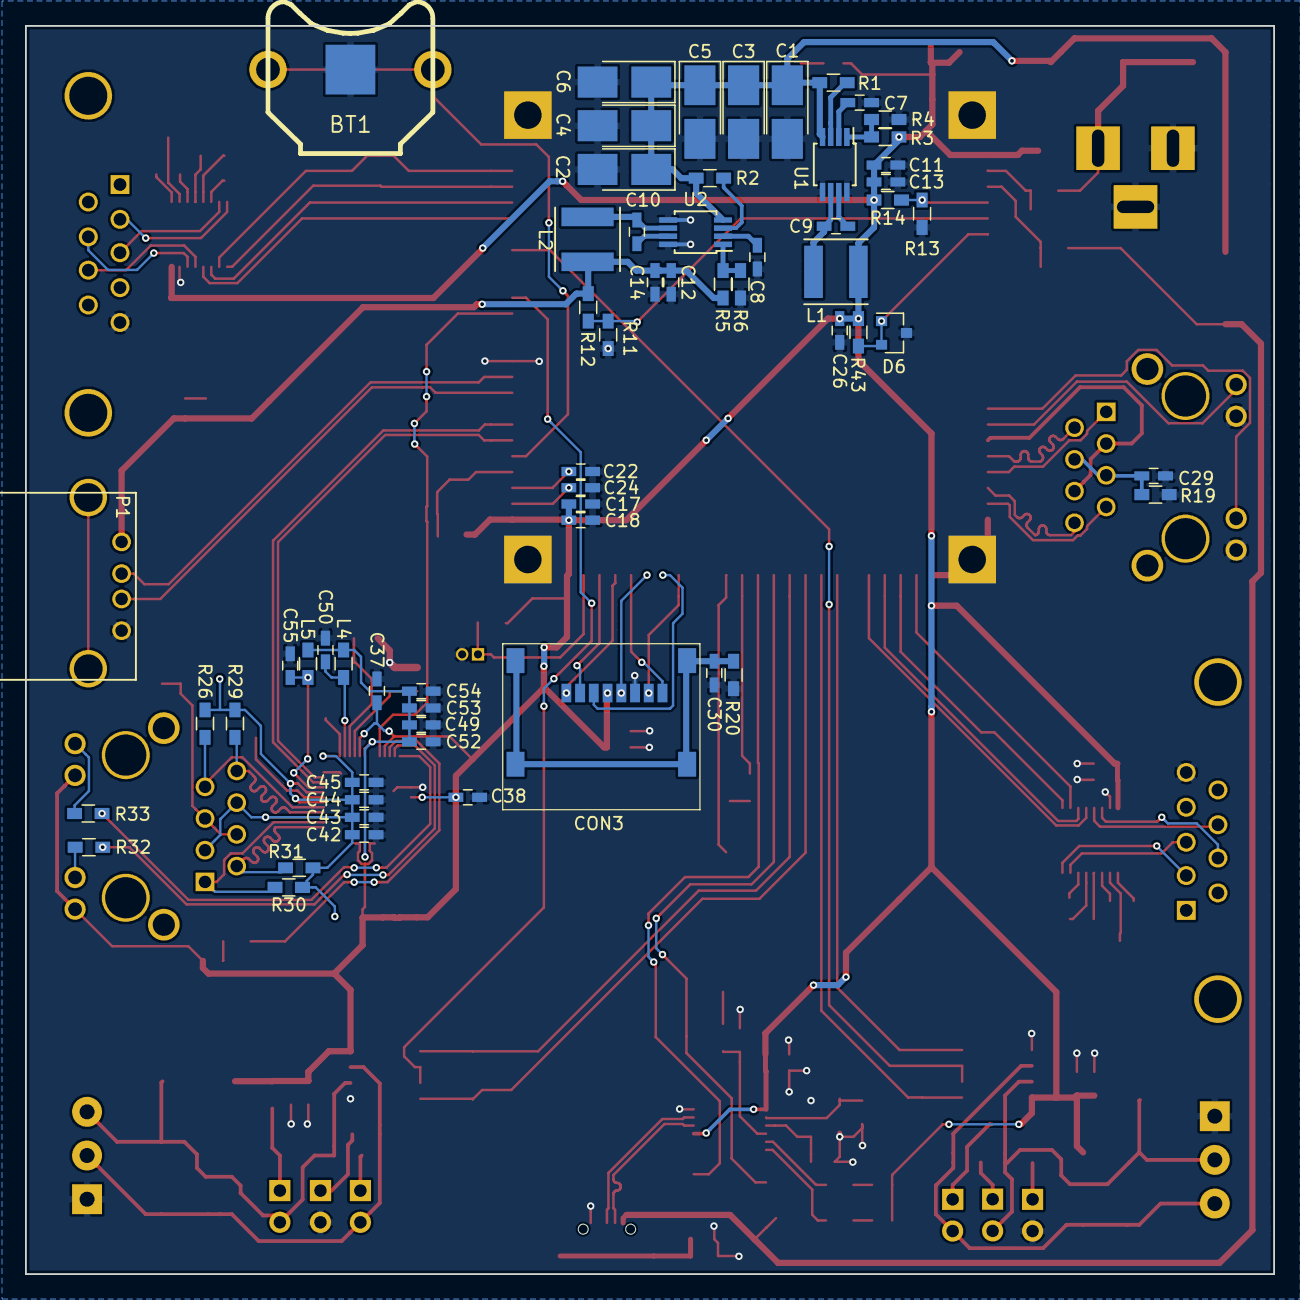
[picture p9: board E-GIF-M-Board.kicad_pcb from below]

Board: 2 copper layers, 100.0 x 100.0 mm, 182 parts (62 on the bottom side), 128 nets.
