grazzland/E-GIF-M-Board/(commit log)

2017-01-16 Added KiCad project with the work done so far. Done the power module. Modified a template for the schematic to add university logo.
    [E-GIF-M-Board.kicad_pcb, E-GIF-M-Board.sch, Power.sch]
2017-01-16 Created branch for Aria Module schematic. Done the VCC, GND and Micro SD conections.
    [AriG25Module.sch, E-GIF-M-Board.sch, Power.sch]
2017-01-17 Added MCP2200, serial to usb converter for debug.
    [AriG25Module.sch, E-GIF-M-Board.sch, Power.sch]
2017-01-18 I will merge and move the interfaces on a new sheet. Modified the schematic of a RJ45 Connector to be the same as the one used in Acme documentation.
    [AriG25Module.sch, E-GIF-M-Board.sch, Power.sch]
2017-01-18 Moved and connected the Debug, MicroSD and EthernetIN(EthIN) in the Interfaces schematic.
    [AriG25Module.sch, E-GIF-M-Board.sch, Interfacesch.sch, Power.sch]
2017-01-23 Added schematic component for LAN9500A and started to work on the sheet for interfacing it.
    [AriG25Module.sch, E-GIF-M-Board.sch, Interfacesch.sch, Power.sch, USB_ETH_conv.sch]
2017-01-29 Finished LAN9500A ETH to USB interface sheet.
    [E-GIF-M-Board.sch, Interfacesch.sch, USB_ETH_conv.sch]
2017-01-30 Finished interfaces.
    Finished MAX3232 serial to RS232 interface.
    Finished ST3485 serial to RS485 interface.
    [AriG25Module.sch, E-GIF-M-Board.sch, Interfaces.sch, Power.sch, SERIAL_RS232_conv.sch, SERIAL_RS485_conv.sch, USB_ETH_conv.sch]
2017-01-30 .bak ignore rule
    Ignore bak files
    [SERIAL_RS232_conv.sch]
2017-01-30 Added some info text.
    [E-GIF-M-Board.sch]
2017-02-05 Added to scheamtic.
    Added reset circuit for Aiya, power led for 3V3 line, USB type A connectors for USBB and USBC.
    [AriG25Module.sch, E-GIF-M-Board.sch, Interfaces.sch, Power.sch, SERIAL_RS232_conv.sch, SERIAL_RS485_conv.sch, USB_ETH_conv.sch]
2017-02-10 Schematic correction
    Corrected the direction on some signals. Added a pin header for general development.
    [AriG25Module.sch, E-GIF-M-Board.sch, Interfaces.sch, Power.sch, SERIAL_RS232_conv.sch, SERIAL_RS485_conv.sch, USB_ETH_conv.sch]
2017-02-16 Modified LAN9500A schematic.
    Modified the schematic for the USB to Ethernet converter.
    [AriG25Module.sch, Interfaces.sch, Power.sch, SERIAL_RS232_conv.sch, SERIAL_RS485_conv.sch, USB_ETH_conv.sch]
2017-02-23 Schematic changes. PCB in process of making.
    Removed LAN9500A Jtag. Removed Aria G25 pinout. Removed USB connectors. Added rezistors to USB/ETH/ySD shields.
    [AriG25Module.sch, E-GIF-M-Board.sch, Interfaces.sch, Power.sch, SERIAL_RS232_conv.sch, SERIAL_RS485_conv.sch, USB_ETH_conv.sch]
2017-02-24 Modified USB/ETH label names.
    [AriG25Module.sch, E-GIF-M-Board.kicad_pcb, E-GIF-M-Board.sch, Interfaces.sch, Power.sch, USB_ETH_conv.sch]
2017-02-28 Finished first version of PCB.
    Modified RJ45 footprint.
    [AriG25Module.sch, E-GIF-M-Board.kicad_pcb, E-GIF-M-Board.sch, Interfaces.sch, Power.sch, SERIAL_RS232_conv.sch, SERIAL_RS485_conv.sch, USB_ETH_conv.sch]
2017-03-02 Modified buck circuit on board.
    [AriG25Module.sch, E-GIF-M-Board.kicad_pcb, Interfaces.sch, Power.sch, SERIAL_RS232_conv.sch, SERIAL_RS485_conv.sch, USB_ETH_conv.sch]
2017-03-05 Removed some capacitors.
    [E-GIF-M-Board.kicad_pcb, SERIAL_RS485_conv.sch]
2017-03-07 Modified schematic. v1.1
    [AriG25Module.sch, E-GIF-M-Board.kicad_pcb, E-GIF-M-Board.sch, Interfaces.sch, Power.sch, SERIAL_RS232_conv.sch, SERIAL_RS485_conv.sch, USB_ETH_conv.sch]
2017-03-09 Modified board. v1.1 to reflect the schematic change.
    [AriG25Module.sch, E-GIF-M-Board.kicad_pcb, E-GIF-M-Board.sch, Interfaces.sch, Power.sch, SERIAL_RS232_conv.sch, SERIAL_RS485_conv.sch]
